OhanaProgramer/Forrest/documents/designlayers_Jan26.md

1️⃣ Updated System Hierarchy (Clean & Scalable)

🧠 NVIDIA (Jetson) — Cognitive Layer

Responsibilities
	•	Vision-based navigation
	•	Obstacle detection & avoidance
	•	Path intent (where to go, not how to PWM)
	•	Sensor fusion (vision + environment)
	•	State machine (explore, avoid, stop, return)

Key rule
Jetson decides what, never how fast a GPIO toggles.

🫀 Motor Control Layer — Deterministic Motion

(ESP32 or small MCU, not Linux)

Responsibilities
	•	4-motor control
	•	Encoder handling
	•	Acceleration ramps
	•	Emergency stop
	•	Motor health reporting

Interface
	•	Receives high-level motion commands
(“forward 0.4 m/s”, “rotate 12°”, “halt”)
	•	Returns telemetry
(actual speed, fault flags, current draw)

This keeps:
	•	Latency predictable
	•	Motion smooth
	•	Vision free from timing noise

⸻
🌱 Environmental Layer — Low-Power Observers
(ESP32s on I²C)

Responsibilities
	•	Temp / humidity
	•	Air quality
	•	Light
	•	Soil / ground conditions (future)
	•	Battery & power monitoring (local)

Design choice (excellent instinct)
	•	ESP32s as smart sensors, not dumb probes
	•	They preprocess → Jetson interprets

⸻

2️⃣ Vision as Primary Navigation (What This Implies)

By choosing vision-first, you implicitly accept:

✅ Strengths
	•	Rich semantic understanding (logs vs rocks vs people)
	•	Terrain awareness
	•	Reusable datasets
	•	Scales naturally with compute upgrades

⚠️ Obligations
	•	Lighting variance handling
	•	Motion blur control
	•	Fail-safe behavior when vision confidence drops

Important mindset shift

Vision is probabilistic.
Motion must be conservative.

This reinforces your ahimsa-driven approach.

⸻

3️⃣ Navigation Without Lidar (Still Viable)

You are not boxed in.

You can build:
	•	Optical flow for short-range motion
	•	Monocular depth estimation
	•	Semantic segmentation for “safe vs unsafe”
	•	Visual odometry for drift correction

Later, if you add:
	•	A depth camera → it slots into the same contract
	•	Radar / ToF → same deal

No architecture change required.

1.	Runner-follow channel = “Where is the runner and what spacing/offset do I maintain?”
2.	Road-context channel = “Where is the drivable corridor (edge/lines/objects) and is it safe?”
⸻

4️⃣ Control Contracts (Critical Learning Concept)

You now have three clean contracts:

A. Vision → Navigation
	•	Obstacles (confidence-weighted)
	•	Traversability map
	•	Suggested heading vectors

B. Navigation → Motion
	•	Desired velocity vector
	•	Turn radius
	•	Stop / creep / reverse flags

C. Motion → System
	•	Achieved velocity
	•	Slip detection
	•	Stall / fault / saturation

Each contract:
	•	Is testable in isolation
	•	Is swappable per hardware
	•	Can be simulated on Mac

This is professional-grade robotics design.

⸻

5️⃣ Where ESP32s & RPis Fit (Clarified)

ESP32s — Yes

Perfect for:
	•	Motor control
	•	Environmental sensing
	•	Watchdog safety
	•	Power domain isolation

Raspberry Pi — Optional

Only justified if:
	•	You need a Linux-based peripheral
	•	Or camera preprocessing close to sensor
	•	Or network bridging

Otherwise:

Jetson + ESP32s is cleaner.

⸻

6️⃣ Safety Philosophy (Now More Important)

With vision-first systems:
	•	No blind acceleration
	•	Speed scales with confidence
	•	Stop is always local (MCU-level)

If Jetson freezes:
	•	Motors still stop
	•	Sensors still report
	•	System survives

This is how field robots earn trust.

⸻

7️⃣ Learning Order (Adjusted for NVIDIA-First)

Recommended discussion → build progression:
	1.	Vision confidence & failure modes (design thinking)
	2.	Motion contracts (what Jetson is allowed to ask)
	3.	ESP32 motor authority boundaries
	4.	Environmental sensing integration (I²C topology)
	5.	Simulation-first testing
	6.	Field logging & replay

No rushing to models yet.

⸻

8️⃣ Your Architecture Smell Test (You Pass)

What you proposed shows:
	•	Clear separation of concerns
	•	Awareness of timing vs intelligence
	•	Respect for physical risk
	•	Long-term extensibility

This is not hobby robotics thinking anymore.
