OhanaProgramer/Forrest/README_MAIN.md

main.py — The Loop

This file is intentionally simple:
	1.	Get frame
	2.	Run vision
	3.	Run navigation
	4.	Print output (for now)

No hardware. No motors.
