OhanaProgramer/Forrest/documents/vision_nav_Jan26.md

The Navigation Picture You’re Building (and it’s coherent)

Channel A — Runner Tracking (Primary Mission)

Goal: maintain a set spatial relationship to the runner (distance + lateral offset).
	•	Inputs: runner position in image + estimated distance (or relative scale) + runner heading
	•	Output: desired relative pose:
	•	Following distance (e.g., 3–6m)
	•	Lateral offset (e.g., 0.5–1.5m to road-side)
	•	Speed target tied to runner velocity

Key: “Velocity is set by spacing error”
That’s basically a control law:
	•	Too close → slow/stop
	•	Too far → speed up (capped)
	•	Perfect spacing → match runner speed

This is stable if you cap acceleration and have smooth ramping (handled by the motor MCU).

⸻

Channel B — Road Context (Safety Envelope)

Goal: confirm the bot is inside a safe corridor and detect hazards.
	•	Inputs: lane line / road edge / curb / shoulder boundary / obstacles
	•	Output: a drivable corridor + risk score
	•	corridor centerline (or “stay right of this boundary”)
	•	stop zones (cars, cyclists, pedestrians, debris)

This channel answers: even if I see the runner, am I about to do something stupid?
