OhanaProgramer/Forrest/sim/README_SIM.md

/sim/ — Learning Accelerator

This is your unfair advantage.
	•	Replay a run
	•	Step frame by frame
	•	Watch confidence collapse or recover

Later this becomes gold.
