OhanaProgramer/Forrest/interfaces/README_INTERFACES.md

/interfaces/ — The Contract Layer

This is critical.
	•	vision_output.py
Defines exactly what comes out of vision:
	•	runner offset
	•	runner distance
	•	road corridor
	•	confidence values

This file is your constitutional amendment.
If this is clean, everything else behaves.
