OhanaProgramer/Forrest/cad/previews/forrest_jr_case_v0_a.png

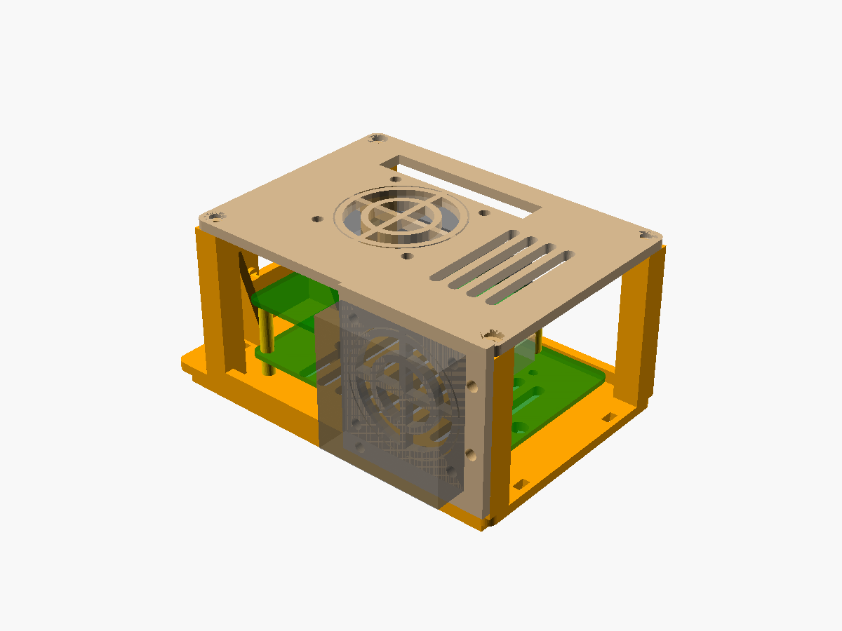
cad/previews/forrest_jr_case_v0_a.png
