OhanaProgramer/Forrest/cad/previews/forrest_jr_case_v0_b.png

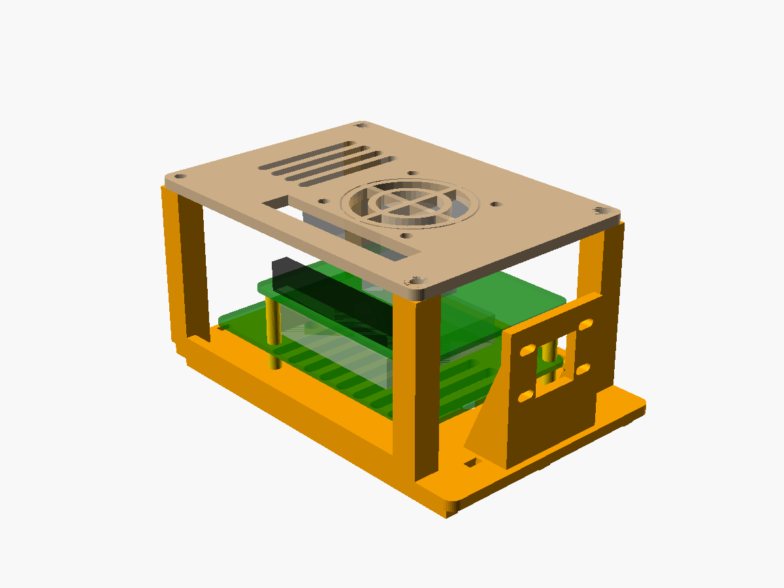
cad/previews/forrest_jr_case_v0_b.png
