OhanaProgramer/Forrest/cad/previews/forrest_jr_case_v0_c.png

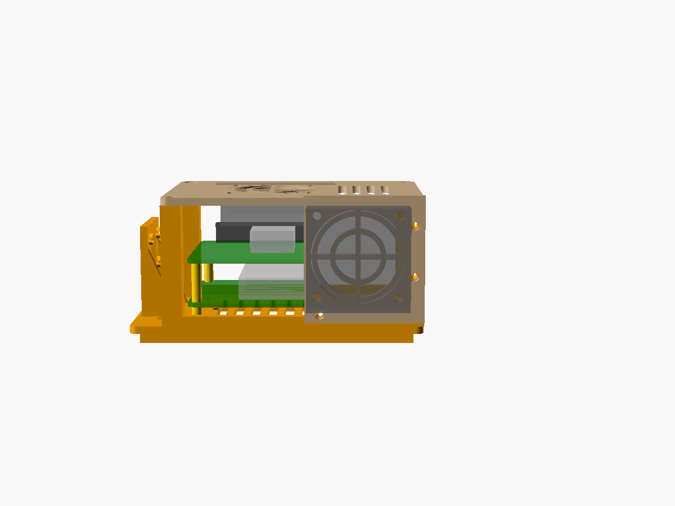
cad/previews/forrest_jr_case_v0_c.png
