OhanaProgramer/Forrest/cad/previews/forrest_jr_pi5_plate_v0_preview.png

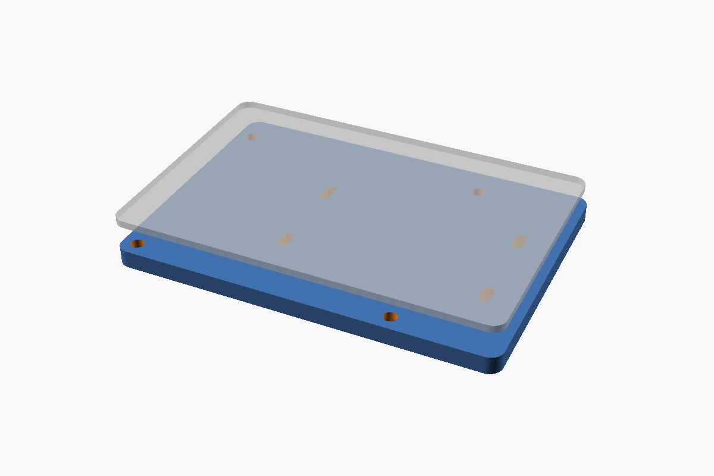
cad/previews/forrest_jr_pi5_plate_v0_preview.png
