OhanaProgramer/Forrest/cad/previews/forrest_jr_pi5_plate_v1_preview_a.png

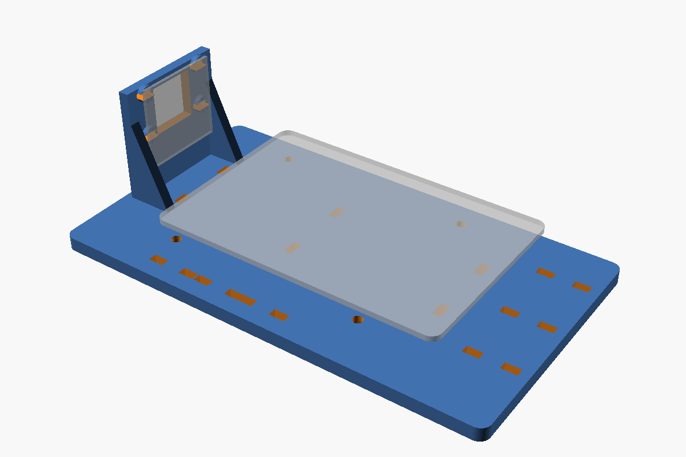
cad/previews/forrest_jr_pi5_plate_v1_preview_a.png
