OhanaProgramer/Forrest/cad/previews/forrest_jr_pi5_plate_v1_preview_b.png

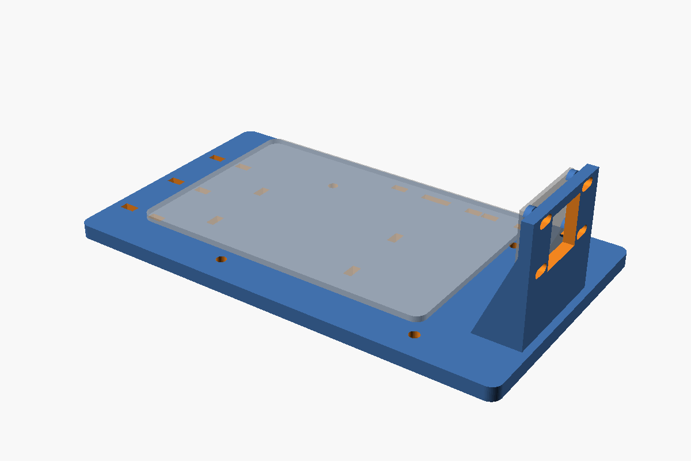
cad/previews/forrest_jr_pi5_plate_v1_preview_b.png
