OhanaProgramer/Forrest/cad/stl/forrest_jr_case_v0_lid.stl

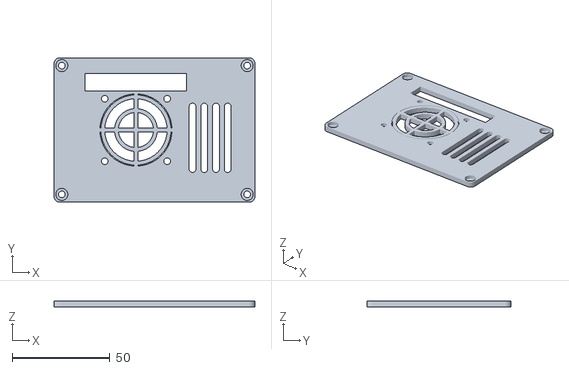
[picture p7: CAD file, 2026-10-28]
cad/stl/forrest_jr_case_v0_lid.stl
103.0 x 74.0 x 3.00
