OhanaProgramer/Forrest/cad/stl/forrest_jr_case_v0_tray.stl

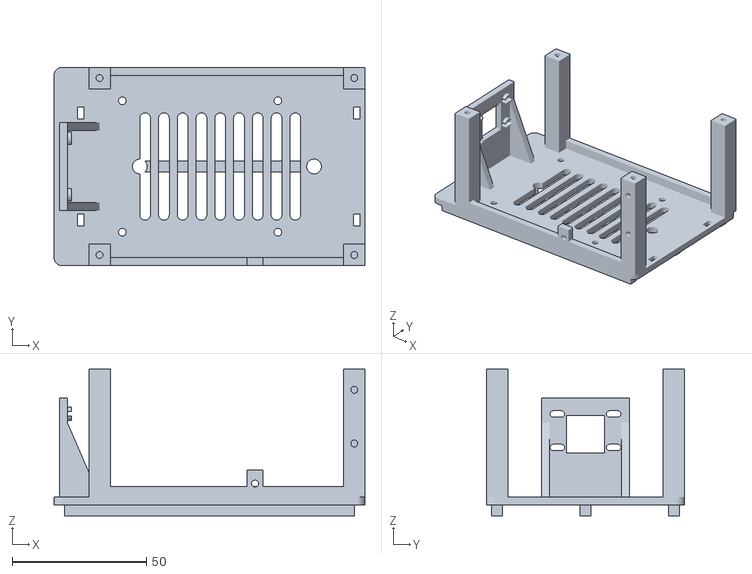
[picture p8: CAD file, 2026-10-28]
cad/stl/forrest_jr_case_v0_tray.stl
116.0 x 74.0 x 54.7
