OhanaProgramer/Forrest/cad/stl/forrest_jr_case_v0_sidefan.stl

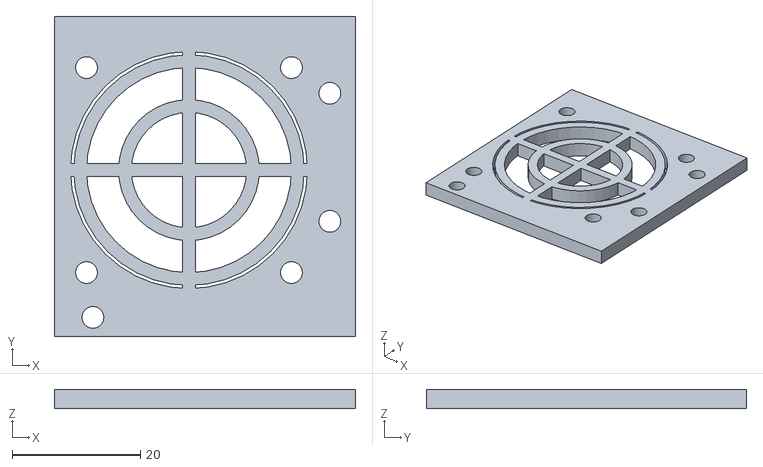
[picture p9: CAD file, 2026-10-28]
cad/stl/forrest_jr_case_v0_sidefan.stl
47.0 x 50.0 x 3.00
