OhanaProgramer/Forrest/cad/stl/forrest_fit_test_v0.stl

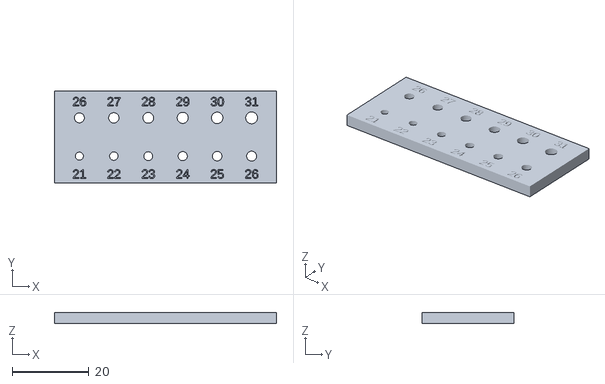
[picture p10: CAD file, 2026-10-25]
cad/stl/forrest_fit_test_v0.stl
58.0 x 24.0 x 3.00
