OhanaProgramer/Forrest/cad/stl/forrest_jr_pi5_plate_v1.stl

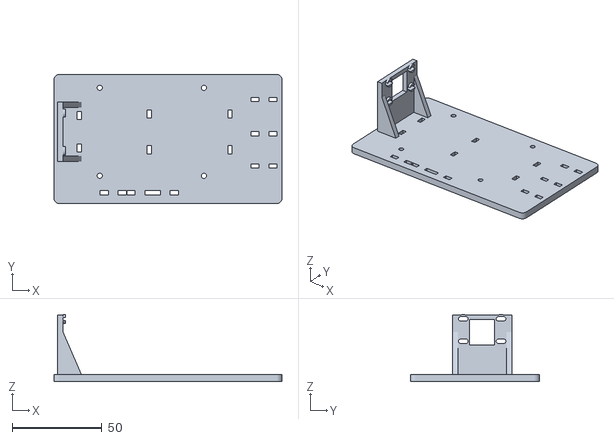
[picture p11: CAD file, 2026-10-25]
cad/stl/forrest_jr_pi5_plate_v1.stl
127.0 x 72.0 x 37.5
