OhanaProgramer/Forrest/cad/stl/forrest_jr_pi5_plate_v0.stl

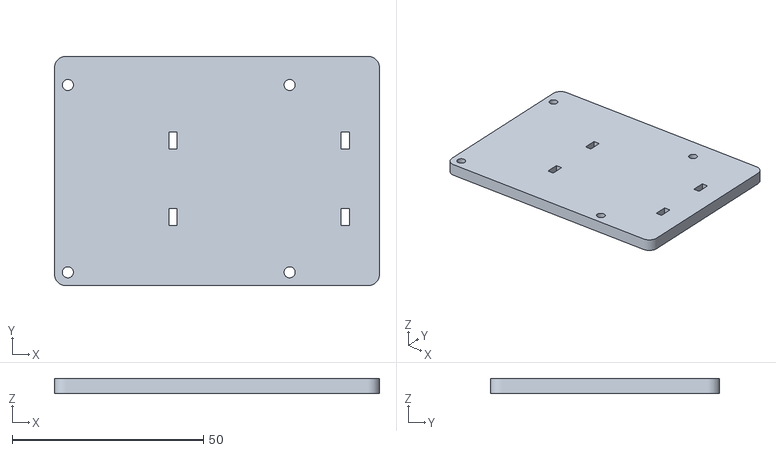
[picture p12: CAD file, 2026-10-25, an earlier design]
cad/stl/forrest_jr_pi5_plate_v0.stl
85.0 x 60.0 x 4.00
