OhanaProgramer/Forrest/(list of files, cad)

Other CAD files:
cad/forrest_jr_pi5_plate_v0.scad
