OhanaProgramer/Forrest/cad/previews/forrest_fit_test_v0_preview.png

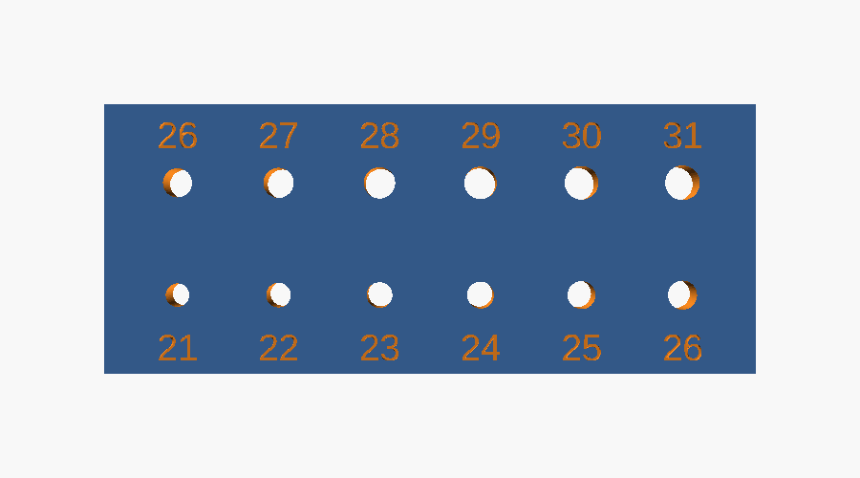
cad/previews/forrest_fit_test_v0_preview.png
