OhanaProgramer/Forrest/(commit log)

2026-10-25 Restart Forrest: bench-first structure for Forrest Jr
    The January 2026 video-first prototype moves to archive/v0_vision_jan26/
    (also tagged archive-v0-jan26). New layout:
    - src/forrest/drivers/lidar_c1.py: RPLIDAR C1 driver (standard protocol,
    460800 baud). Written from the datasheet; not yet run on the real unit.
    - src/forrest/sensing/scan.py: Scan, sectors, record/replay (.jsonl)
    - src/forrest/health/pi_power.py: vcgencmd throttled/temperature parsing
    - `forrest` command: lidar check/record/view, soak (B2), power
    - pi/setup_pi.sh: venv, dialout group, usb_max_current_enable
    - docs/BENCH.md: B1/B2 runbook; CLAUDE.md: repo working rules
    - cad/: Pi plate v0/v1 and fit-test strip (scad, stl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
    [forrest_fit_test_v0.scad, forrest_fit_test_v0.stl, forrest_jr_pi5_plate_v0.scad, forrest_jr_pi5_plate_v0.stl, forrest_jr_pi5_plate_v1.scad, forrest_jr_pi5_plate_v1.stl]
2026-10-28 cad: open cage case v0 for Pi 5 + AI HAT+ (tray + lid)
    Claude-Session: https://claude.ai/code/session_01Tz7iNuNQtARUh2YxRjgnTE
    [forrest_jr_case_v0.scad, forrest_jr_case_v0_lid.stl, forrest_jr_case_v0_tray.stl]
2026-10-28 cad: case v0 adds optional front side-fan bracket
    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
    [forrest_jr_case_v0.scad, forrest_jr_case_v0_lid.stl, forrest_jr_case_v0_sidefan.stl, forrest_jr_case_v0_tray.stl]
2026-10-30 Hoverboard drive board: flow of events, firmware settings, serial driver
    - firmware/hoverboard/README.md: gated steps H0-H7 from Mac setup to the Drive card
    - prepare.sh + forrest_config.py: EFeru FOC firmware pinned at 4f141cb with
    VARIANT_USART, tank steering, bench limits (5 A, 200 rpm)
    - mac_setup.sh: stlink, openocd, platformio; ST-Link probe
    - drivers/hoverboard.py: command/feedback protocol with resync (untested on hardware)
    - forrest drive listen / spin (spin capped at |150| by default)
    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
2026-10-30 Hoverboard runbook: ST-Link pin check, staying-recoverable notes
    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
2026-10-30 web: Forrest status page for the home-lab hub (static /forrest/)
    Self-contained dark-theme page in George's visual style; data-driven by
    forrest.json (edit it to update). deploy.sh pushes it to the mini hub at
    /forrest/. Live Pi feed wires into the 'latest' panel later.
    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
2026-11-02 firmware/hoverboard: pivot to MM32SPIN05 path + Claude Code handoff
    Jr's board is the HY-A02C MM32SPIN05PF split pair, not an STM32 single board, so:
    - README.md rewritten as the MM32 runbook (M0-M7): pyOCD flash, trondin firmware,
    SWD/UART pins from the reference pinout, flash-both-halves plan.
    - mm32/: vendored prebuilt firmware.hex + pinout.jpg + schematic.jpg (source trondin).
    - HANDOFF.md: current state, confirmed vs to-verify, rules, repo map for a local
    Claude Code session to pick up.
    - STM32/EFeru path moved to reference_stm32/ (kept for a possible future STM32 board).
    - Serial driver unchanged: trondin feedback/command structs match 0xABCD protocol.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
2026-11-02 firmware/hoverboard: M1 CP2102 loopback passed; M2 is current step
2026-11-04 firmware/hoverboard: expand M2 into a full meter-only hardware ID + bench test
    Pre-computer board characterization: ID every key pin (SWD, UART, chip) by meter
    on both halves, continuity sanity (no shorts, phase continuity), powered rails
    (pack, +12V, 3.3V). Only attach the computer (M3) after this passes.
    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
2026-11-04 Drop hoverboard drive; add root HANDOFF.md for MacBook <-> forrest-jr sync
    Hoverboard path abandoned (2026-11-04): delete firmware/hoverboard, the
    serial driver, its tests and the 'forrest drive' CLI. Drive base will be a
    1/10 RC truck (future). HANDOFF.md carries open items and proposed
    Continuity edits between the MacBook and the Pi.
2026-11-04 HANDOFF: camera + Hailo ops test, first pass results
2026-11-04 gitignore: keep camera test captures out of git
2026-11-04 Camera + Hailo vision loop, 'forrest view' window, dashboard v0
    - drivers/camera_hailo.py: one owner of camera + Hailo; YOLOv8s at 29.9 fps
    on forrest-jr (1280x960 main, 640x640 lores)
    - sensing/detections.py: Hailo NMS output -> Detection (tested)
    - forrest view: desktop window with boxes, fps, temp
    - forrest dash: status + MJPEG web server bound to Tailscale (v0)
    - venv now built with --system-site-packages (picamera2, hailo_platform)
2026-11-04 Dashboard step 1: hardware strip
    One row of tiles: CPU, AI HAT temp, power (throttle + input V), fan,
    memory, disk, Wi-Fi, Tailscale, uptime. Green/amber/red limits in one
    place (status.LIMITS). Reads /proc, /sys, vcgencmd, tailscale; no sudo.
    Camera now opt-in (--camera). 20 tests, no hardware needed.
2026-11-04 Dashboard step 2: scientific visual pass
    - Stat tiles with 2-min sparklines (current value as accent dot) or limit
    meters; status shown as icon + word, never colour alone
    - 30-min history charts: temperature (caution/throttle lines, headroom),
    CPU load, network throughput; crosshair + tooltip on hover
    - Header summary (nominal / caution / at limit), host model + kernel
    - Readings table with units and data source for every value
    - Background sampler every 2 s with a 30-min ring buffer; /api/history
    returns only new rows with ?since=
    - CPU split into load and temperature tiles
2026-11-08 Dashboard: group Now tiles into Thermal / Power / System / Network
    Each group answers one question (is it hot? is the supply clean? is it
    keeping up? can I reach it?). status.GROUPS sets the order; /api/status
    now sends the groups; the page rebuilds the layout only when the set of
    tiles changes.
2026-11-08 Pico drive firmware (as found on the board) + HANDOFF: Pico bench focus
    Copied main.py and protocol.py off the Pico 2 into the paths their
    headers name: firmware/pico/drive/protocol.py and
    firmware/pico/drive/bench/main.py. Untested beyond the bench; nothing
    is wired to GP0/GP1.
    HANDOFF: new item 3 (Pico bench + monitoring plan), a MacBook ask to
    push the original drive tree and tests, and the Continuity edits.
2026-11-08 Pico firmware: split into comm / heartbeat / protocol modules
    main.py now only wires the modules together:
    - comm.py: non-blocking USB serial. Assembles whole lines, so a half-sent
    line no longer blocks the loop (the old readline() could freeze the
    failsafe check). Drops lines over 64 chars.
    - heartbeat.py: Pi-is-alive watchdog behind the failsafe; wrap-safe time.
    - protocol.py: unchanged.
    STAT gains a trailing trips count. Host tests for all three pure modules.
    firmware/pico/deploy.sh deploys with mpremote (added to the dev extras).
    Bench-verified on the Pico 2 (no ESC/servo): failsafe trips 514 ms after
    the last command in 5 of 5 trials.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
    [comm.py, heartbeat.py, main.py, test_pico_comm.py, test_pico_heartbeat.py, test_pico_protocol.py]
2026-11-08 Pi-side Pico driver + `forrest pico check`
    drivers/pico.py is the Pi's half of the serial link: parses the Pico's
    READY/OK/BAD/FAILSAFE/STAT replies (unreadable lines become UNKNOWN,
    never an exception), finds the Pico by USB id, opens the port exclusive
    so only one program can hold it, and drops the tty echo seen on open.
    status() polls "?" and does not feed the heartbeat; send_command() is
    the heartbeat, for a future controller only.
    `forrest pico check` polls status read-only and reports link UP/DOWN.
    Run on the Pico 2: link UP, ~6-7 ms round trip; a second opener is
    refused while the port is held.
    [pico.py, test_pico_driver.py]
2026-11-08 pico check: report 'link lost' when the Pico is unplugged mid-run
2026-11-08 Pico monitor: `forrest pico monitor` + forrest-pico service (not installed)
    health/pico_monitor.py polls the Pico's status once a second (read-only,
    never a drive command), marks the link down after 3 s without an answer,
    reconnects after an unplug, and publishes:
    - $XDG_RUNTIME_DIR/forrest/pico.json, replaced atomically each poll, for
    the dashboard (an old "updated" means the monitor isn't running);
    - data/pico/pico_YYYYMMDD.jsonl: every event and link change, plus a
    status sample every 10 s (~1.3 MB/day).
    pi/systemd/forrest-pico.service + install-pico.sh, same pattern as
    forrest-dash. Ran 8 s on the Pico 2: 8/8 answered, ~5 ms round trip.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
    [test_pico_monitor.py]
2026-11-08 Dashboard: Pico panel (link, drive output, loop, trips + event list)
    dashboard/pico.py turns the forrest-pico monitor's state file into tiles
    in a new "Pico: is the safety bridge alive?" group, plus the recent event
    list. The dashboard never opens the Pico's port. Levels: not plugged in =
    caution, plugged in but silent = at limit, monitor stopped (state older
    than 5 s) = no data. New limit pico_gap_ms (caution 50, limit 150 ms).
    Checked live on forrest-jr: desktop and phone width, and stopping the
    monitor shows "no data" until it is started again.
2026-11-08 Dashboard: status lights per group; groups and history fold
    A bar of red/yellow/green lights, one per group (worst tile wins), with a
    short reason under a yellow/red light, replaces the header summary.
    Green groups fold; yellow/red open by themselves and close again when
    back to green. Clicking a light overrides that, remembered per browser;
    a manual close is dropped if the group gets worse. History is folded and
    opens by itself on any red. Charts are only drawn while visible.
    Checked on forrest-jr: all-green view, and a simulated Pico link-down
    (Pico opens with its events, History opens).
2026-11-08 Dashboard layout: lights header, always-on sidebar, radar + camera views
    - Header: the status lights. Sidebar (dashboard/sidebar.py): Environment,
    Position, Robot; sensors not fitted yet show as one "no sensor yet" line
    per section and fill in when their drivers pass readings.
    - Main: two live views. Radar (LIDAR top-down, 1 m rings; frame only until
    bench test B1) and Camera (stream with --camera, otherwise a note).
    - Health groups, Pico events and History open as a drawer over the views
    (full screen on a phone). Auto-open waits for ~6 s (3 samples) of
    yellow/red so a short CPU spike only flashes the light; a manual close
    is cleared once the group is green again.
    Checked on for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
    [test_dashboard_sidebar.py]
2026-11-08 Dashboard: OFFLINE card when the Pi is lost; fps badge on the camera
    After 6 s without an answer from the Pi, the page drops the frozen camera
    frame and shows an OFFLINE card with the last-frame time, marks the radar
    OFFLINE, greys the lights and sidebar, and says "OFFLINE since ..." in the
    header. It reconnects by itself (fresh stream URL); a stream that drops
    while the page is still connected retries after 2 s. A camera error from
    the vision loop is shown instead of the "camera off" note.
    The frame rate is now a badge on the image (it was easy to miss in the
    title). Checked with a stand-in server that stops answering.
2026-11-09 HANDOFF: fill in why the hoverboard drive was dropped
    Replaces the 'Jacque to fill in' placeholder with the rationale (single
    clean header on the HY-A02C; second control line would need 0.5mm chip-leg
    soldering, past the clean-build bar; both boards returned; pivot to an
    off-the-shelf RC car, VESC/ODrive hub-motor build parked for Sr). Ready for
    the MacBook session to move into Continuity DECISIONS.md.
    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
2026-11-09 HANDOFF: queue camera-architecture decision + Jr camera test plan for Continuity
    Two independent cameras (rear tele = overtaking-car detection; front wide =
    cross-traffic/follow backup); stereo pair dropped (rigid-baseline/calibration
    fragility); lens drives range not height; duty-cycle inference on one Pi+Hailo;
    Jetson+GMSL/global-shutter parked as the Sr option, decided with the camera.
    Plus the Jr test plan: forward-solo pipeline test + roadside oncoming-traffic
    detection test (empirically picks the lens). For a MacBook session to move into
    DECISIONS.md / SYSTEMS.md.
    Claude-Session: https://claude.ai/code/session_01Tz7iNuNQtARUh2YxR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
2026-11-11 Pico: pick boards by USB serial number; add the Pico W sensor board
    Every MicroPython board reports the same USB id (2e8a:0005), so with two
    Picos plugged in the driver could open the wrong one. BOARDS maps a name
    to a serial (drive: Pico 2 1c4e1cea890aaffb, sensors: Pico W
    e6616408430b7439); the driver refuses rather than falling back to "any
    Pico", and says which boards it does see.
    - forrest pico list: boards on USB and which is which
    - forrest pico check --board <name>
    - deploy.sh connects by id:<drive serial> instead of auto
    [pico.py, test_pico_driver.py]
2026-11-11 Dashboard: show both Picos (drive link + sensor board on USB)
    The "Picos" group now has a Sensor Pico tile (USB presence from /sys,
    port never opened) next to the drive Pico's monitor tiles, plus a caution
    tile for any MicroPython board not in BOARDS. Sidebar gains a Sensor Pico
    row; table rows name their real source.
2026-11-11 HANDOFF: Pico W sensor board, boards by serial, deploy test; queue two-Pico decision for Continuity
2026-11-11 docs(bench): note ATORCH power/energy meter as the B1/B2 power instrument
    Capability record so we use it during testing: integrates Wh/mAh over time,
    Bluetooth CSV logging, 5-30V DC input (reads the battery side too, not just
    5V USB), ~5A ceiling. Lists the operating points to capture. Points to the
    INA219/P, telemetry as the permanent on-board version.
    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
